SebasdaviD/Treep_Movility/Informacion_microcontrolador/pines esp32.jpg

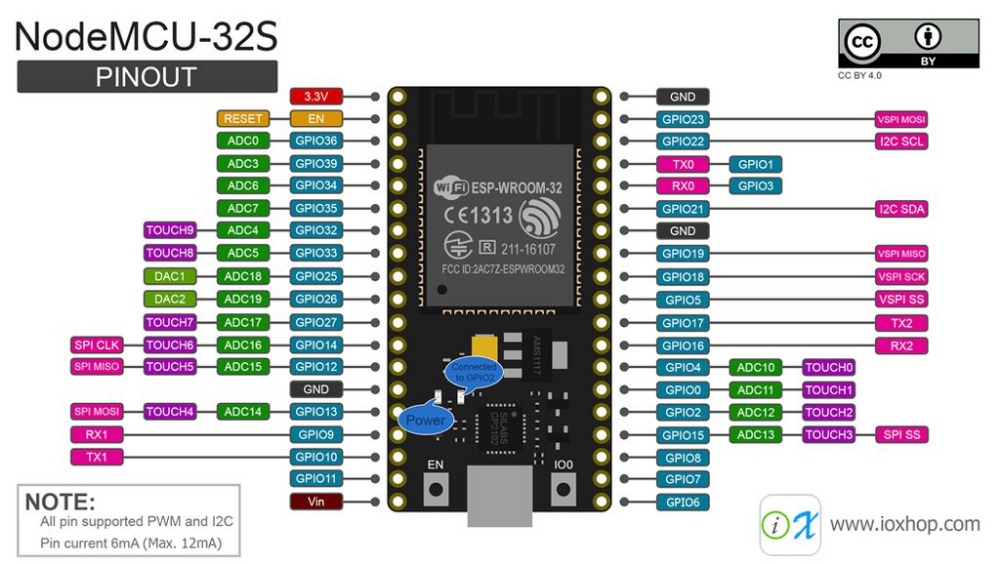
Informacion_microcontrolador/pines esp32.jpg
