SebasdaviD/Treep_Movility/Informacion_microcontrolador/Pines.jpg

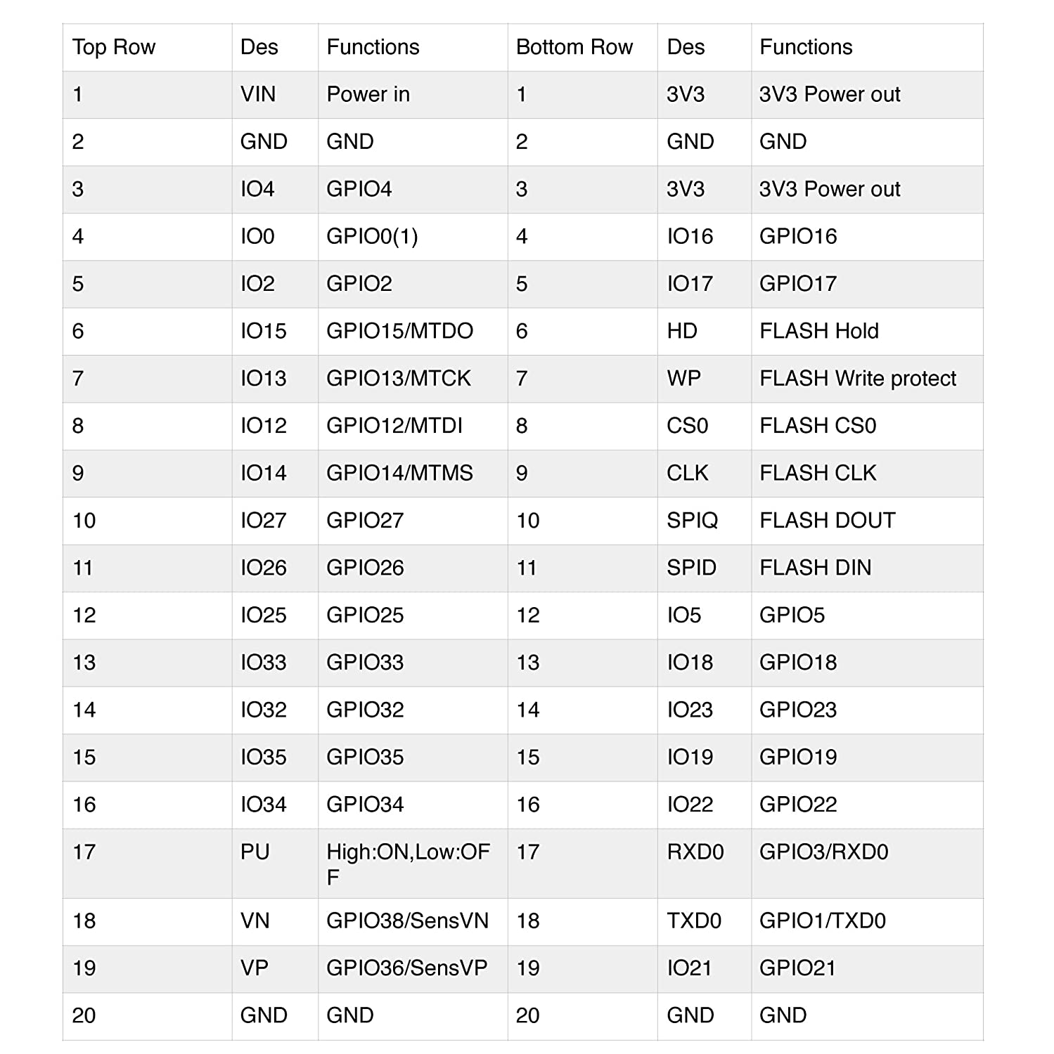
Informacion_microcontrolador/Pines.jpg
