SebasdaviD/Treep_Movility/Informacion_microcontrolador/Pull_up_pull_down.png

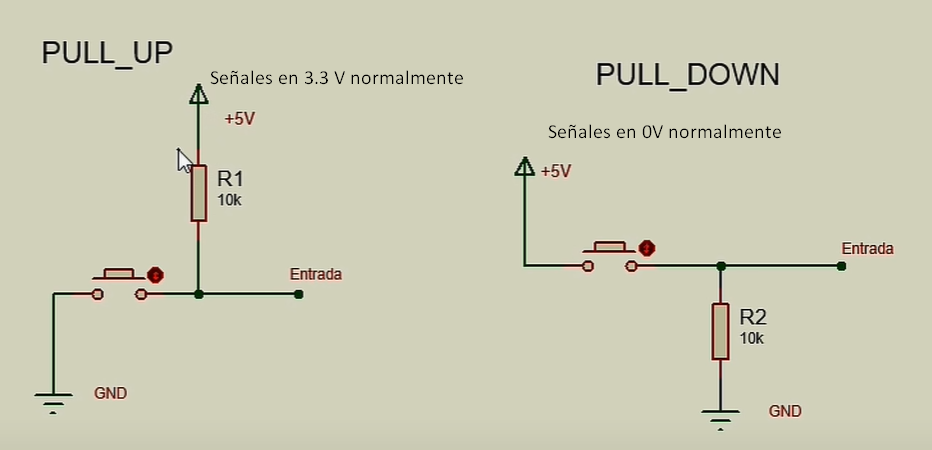
Informacion_microcontrolador/Pull_up_pull_down.png
