SebasdaviD/Treep_Movility/(list of files, cad)

Other CAD files:
PCB/prototipo_2/frecad.FCStd
PCB/prototipo_3/plano_de_cortes.amf
PCB/prototipo_3/frecad.FCStd
PCB/prototipo_3/plano_de_cortes.dxf
