SebasdaviD/Treep_Movility/PCB/prototipo_2/prototipo_2.kicad_pcb

## KiCad design PCB/prototipo_2/prototipo_2.kicad_pcb (2021-10-01)

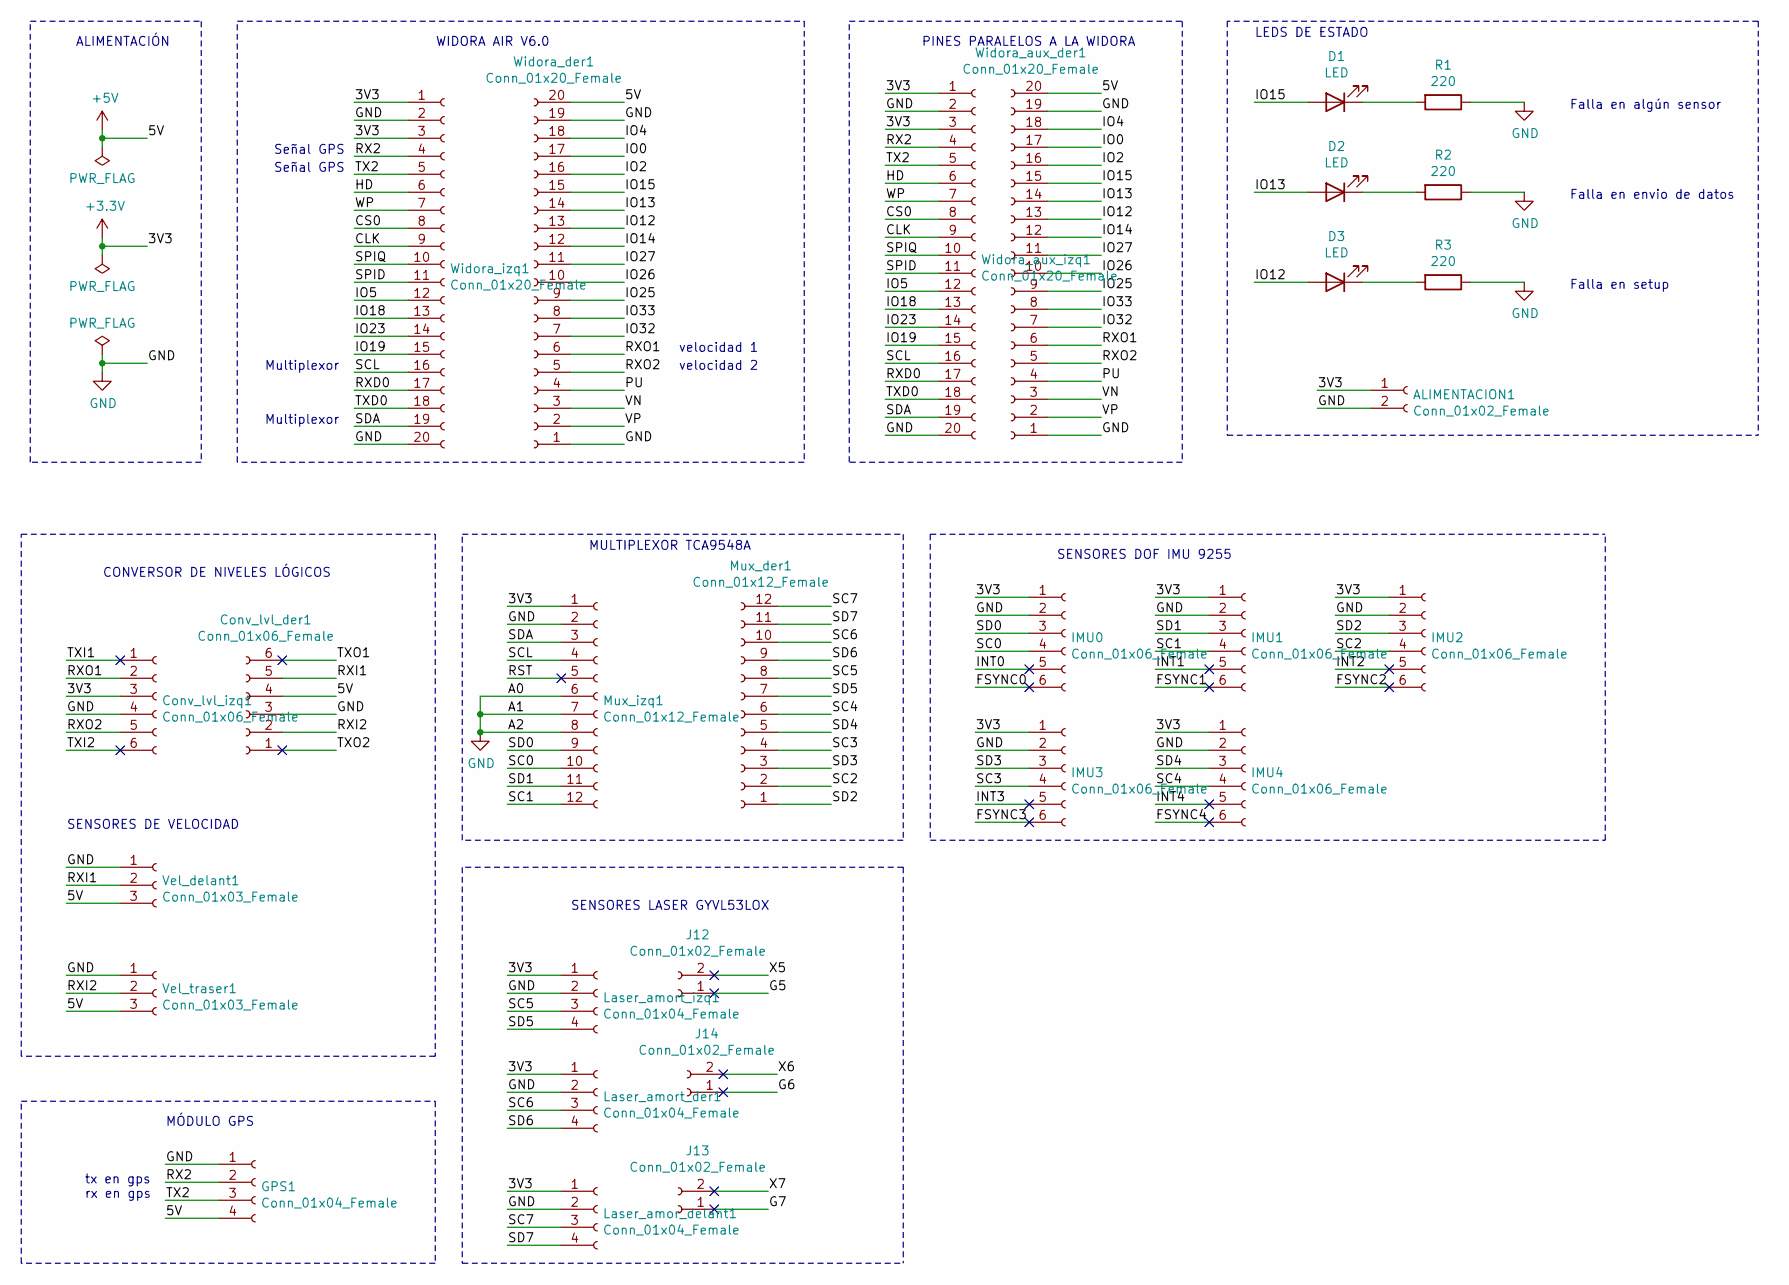
[picture p30: schematic prototipo_2.sch]

Parts:
ALIMENTACION1: Conn_01x02_Female; PinSocket_1x02_P2.54mm_Vertical
Conv_lvl_der1: Conn_01x06_Female; PinSocket_1x06_P2.54mm_Vertical
Conv_lvl_izq1: Conn_01x06_Female; PinSocket_1x06_P2.54mm_Vertical
D1, D2, D3: LED; LED_D5.0mm
GPS1: Conn_01x04_Female; PinSocket_1x04_P2.54mm_Vertical
IMU0, IMU1, IMU2, IMU3, IMU4: Conn_01x06_Female; PinSocket_1x06_P2.54mm_Vertical
J12, J13, J14: Conn_01x02_Female; PinSocket_1x02_P2.54mm_Vertical
Laser_amor_delant1: Conn_01x04_Female; PinSocket_1x04_P2.54mm_Vertical
Laser_amort_der1: Conn_01x04_Female; PinSocket_1x04_P2.54mm_Vertical
Laser_amort_izq1: Conn_01x04_Female; PinSocket_1x04_P2.54mm_Vertical
Mux_der1: Conn_01x12_Female; PinSocket_1x12_P2.54mm_Vertical
Mux_izq1: Conn_01x12_Female; PinSocket_1x12_P2.54mm_Vertical
R1, R2, R3: 220; R_Axial_DIN0411_L9.9mm_D3.6mm_P12.70mm_Horizontal
Vel_delant1: Conn_01x03_Female; PinSocket_1x03_P2.54mm_Vertical
Vel_traser1: Conn_01x03_Female; PinSocket_1x03_P2.54mm_Vertical
Widora_aux_der1: Conn_01x20_Female; PinSocket_1x20_P2.54mm_Vertical
Widora_aux_izq1: Conn_01x20_Female; PinSocket_1x20_P2.54mm_Vertical
Widora_der1: Conn_01x20_Female; PinSocket_1x20_P2.54mm_Vertical
Widora_izq1: Conn_01x20_Female; PinSocket_1x20_P2.54mm_Vertical

Connections:
+3V3: ALIMENTACION1.1, Conv_lvl_izq1.3, IMU0.1, IMU1.1, IMU2.1, IMU3.1, IMU4.1, Laser_amor_delant1.1, Laser_amort_der1.1, Laser_amort_izq1.1, Mux_izq1.1, Widora_aux_izq1.1, Widora_aux_izq1.3, Widora_izq1.1, Widora_izq1.3
+5V: Conv_lvl_der1.4, GPS1.4, Vel_delant1.3, Vel_traser1.3, Widora_aux_der1.20, Widora_der1.20
/CLK: Widora_aux_izq1.9, Widora_izq1.9
/CS0: Widora_aux_izq1.8, Widora_izq1.8
/FSYNC0: IMU0.6
/FSYNC1: IMU1.6
/FSYNC2: IMU2.6
/FSYNC3: IMU3.6
/FSYNC4: IMU4.6
/G5: J12.1
/G6: J14.1
/G7: J13.1
/HD: Widora_aux_izq1.6, Widora_izq1.6
/INT0: IMU0.5
/INT1: IMU1.5
/INT2: IMU2.5
/INT3: IMU3.5
/INT4: IMU4.5
/IO0: Widora_aux_der1.17, Widora_der1.17
/IO2: Widora_aux_der1.16, Widora_der1.16
/IO4: Widora_aux_der1.18, Widora_der1.18
/IO5: Widora_aux_izq1.12, Widora_izq1.12
/IO12: D3.2 (A), Widora_aux_der1.13, Widora_der1.13
/IO13: D2.2 (A), Widora_aux_der1.14, Widora_der1.14
/IO14: Widora_aux_der1.12, Widora_der1.12
/IO15: D1.2 (A), Widora_aux_der1.15, Widora_der1.15
/IO18: Widora_aux_izq1.13, Widora_izq1.13
/IO19: Widora_aux_izq1.15, Widora_izq1.15
/IO23: Widora_aux_izq1.14, Widora_izq1.14
/IO25: Widora_aux_der1.9, Widora_der1.9
/IO26: Widora_aux_der1.10, Widora_der1.10
/IO27: Widora_aux_der1.11, Widora_der1.11
/IO32: Widora_aux_der1.7, Widora_der1.7
/IO33: Widora_aux_der1.8, Widora_der1.8
/PU: Widora_aux_der1.4, Widora_der1.4
/RST: Mux_izq1.5
/RX2: GPS1.2, Widora_aux_izq1.4, Widora_izq1.4
/RXD0: Widora_aux_izq1.17, Widora_izq1.17
/RXI1: Conv_lvl_der1.5, Vel_delant1.2
/RXI2: Conv_lvl_der1.2, Vel_traser1.2
/RXO1: Conv_lvl_izq1.2, Widora_aux_der1.6, Widora_der1.6
/RXO2: Conv_lvl_izq1.5, Widora_aux_der1.5, Widora_der1.5
/SC0: IMU0.4, Mux_izq1.10
/SC1: IMU1.4, Mux_izq1.12
/SC2: IMU2.4, Mux_der1.2
/SC3: IMU3.4, Mux_der1.4
/SC4: IMU4.4, Mux_der1.6
/SC5: Laser_amort_izq1.3, Mux_der1.8
/SC6: Laser_amort_der1.3, Mux_der1.10
/SC7: Laser_amor_delant1.3, Mux_der1.12
/SCL: Mux_izq1.4, Widora_aux_izq1.16, Widora_izq1.16
/SD0: IMU0.3, Mux_izq1.9
/SD1: IMU1.3, Mux_izq1.11
/SD2: IMU2.3, Mux_der1.1
/SD3: IMU3.3, Mux_der1.3
/SD4: IMU4.3, Mux_der1.5
/SD5: Laser_amort_izq1.4, Mux_der1.7
/SD6: Laser_amort_der1.4, Mux_der1.9
/SD7: Laser_amor_delant1.4, Mux_der1.11
/SDA: Mux_izq1.3, Widora_aux_izq1.19, Widora_izq1.19
/SPID: Widora_aux_izq1.11, Widora_izq1.11
/SPIQ: Widora_aux_izq1.10, Widora_izq1.10
/TX2: GPS1.3, Widora_aux_izq1.5, Widora_izq1.5
/TXD0: Widora_aux_izq1.18, Widora_izq1.18
/TXI1: Conv_lvl_izq1.1
/TXI2: Conv_lvl_izq1.6
/TXO1: Conv_lvl_der1.6
/TXO2: Conv_lvl_der1.1
/VN: Widora_aux_der1.3, Widora_der1.3
/VP: Widora_aux_der1.2, Widora_der1.2
/WP: Widora_aux_izq1.7, Widora_izq1.7
/X5: J12.2
/X6: J14.2
/X7: J13.2
GND: ALIMENTACION1.2, Conv_lvl_der1.3, Conv_lvl_izq1.4, GPS1.1, IMU0.2, IMU1.2, IMU2.2, IMU3.2, IMU4.2, Laser_amor_delant1.2, Laser_amort_der1.2, Laser_amort_izq1.2, Mux_izq1.2, Mux_izq1.6, Mux_izq1.7, Mux_izq1.8, R1.1, R2.1, R3.1, Vel_delant1.1, Vel_traser1.1, Widora_aux_der1.1, Widora_aux_der1.19, Widora_aux_izq1.2, Widora_aux_izq1.20, Widora_der1.1, Widora_der1.19, Widora_izq1.2, Widora_izq1.20
unnamed: D1.1 (K), R1.2
unnamed: D2.1 (K), R2.2
unnamed: D3.1 (K), R3.2

Notes on the sheet:
SENSORES DOF IMU 9255
SENSORES LASER GYVL53LOX
SENSORES DE VELOCIDAD
CONVERSOR DE NIVELES LÓGICOS
tx en gps rx en gps
MÓDULO GPS
WIDORA AIR V6.0
velocidad 1
velocidad 2
Señal GPS
Multiplexor
PINES PARALELOS A LA WIDORA
Falla en algún sensor
Falla en envio de datos
Falla en setup
LEDS DE ESTADO
MULTIPLEXOR TCA9548A
ALIMENTACIÓN

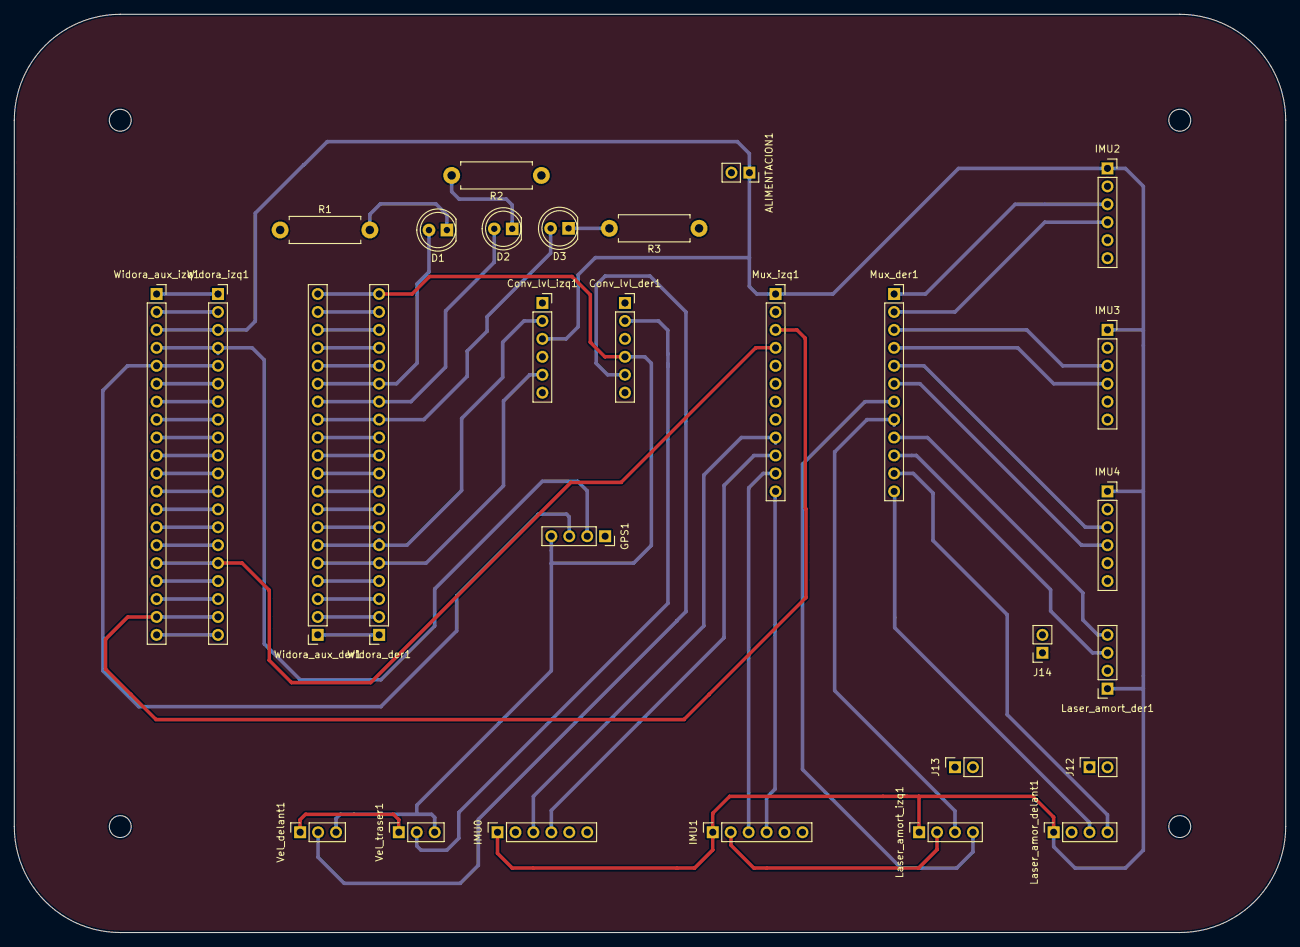
[picture p31: board prototipo_2.kicad_pcb from above]

Board: 2 copper layers, 180.0 x 130.0 mm, 29 parts (0 on the bottom side), 57 nets.
