SebasdaviD/Treep_Movility/(commit log)

2021-06-16 Se agrega código de sensor de velocidad en dos ńucleos
2021-06-16 Actualización de documento oficial e informe
2021-10-01 Se agrega al codigo principal la medicion de distancia
    [frecad.FCStd, plano_de_cortes.amf, plano_de_cortes.dxf, prototipo_1.kicad_pcb, prototipo_1.sch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]
2021-10-23 Agregado al codigo principal el modulo de lectura SD con sus respectivas librerias
2021-10-27 Agregado una nueva forma de medir la velocidad, pero al pasar al microcontrolador principal se reinicio, probablemente se deba usar el conversor de niveles logicos, dicho codigo fue agregado tambien 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
